xtedxX/2627_ESE_Projet_HAL_95/README.md

# 2627_ESE_Projet_HAL_95
A repository dedicated to the project of the ESE course at ENSEA
