xtedxX/2627_ESE_Projet_HAL_95/Hardware/PCB/HAL_95/PCB_contour.dxf

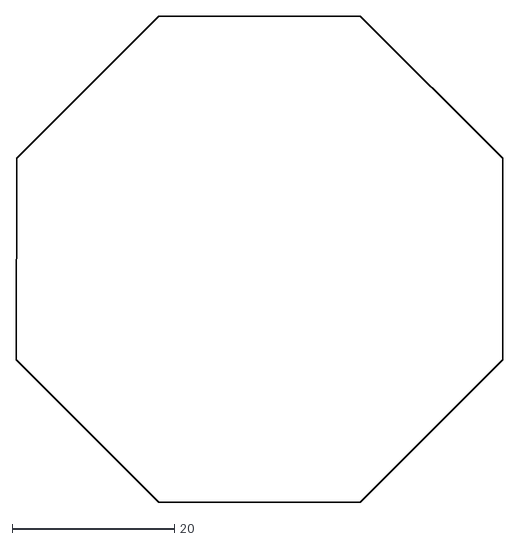
[picture p1: CAD file, 2026-09-26]
Hardware/PCB/HAL_95/PCB_contour.dxf
60.0 x 60.0
