xtedxX/2627_ESE_Projet_HAL_95/Hardware/PCB/HAL_95/PCB_contour_7x7.dxf

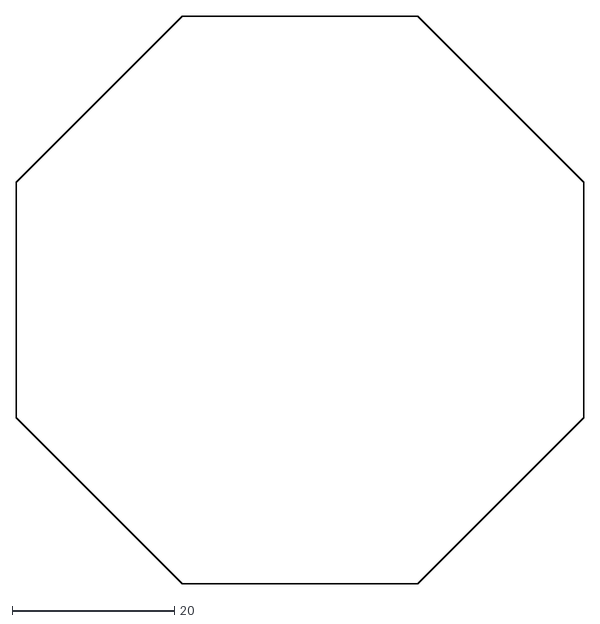
[picture p2: CAD file, 2026-09-26]
Hardware/PCB/HAL_95/PCB_contour_7x7.dxf
70.0 x 70.0
