xtedxX/2627_ESE_Projet_HAL_95/Hardware/PCB/HAL_95/PCB_contour_8x8.dxf

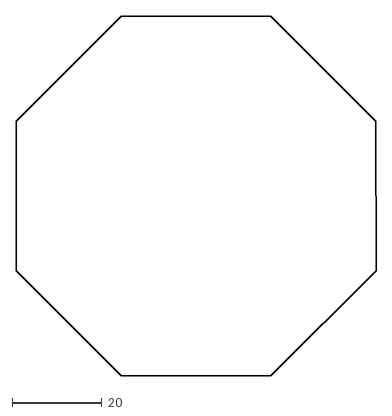
[picture p3: CAD file, 2026-09-26]
Hardware/PCB/HAL_95/PCB_contour_8x8.dxf
80.0 x 80.0
