xtedxX/2627_ESE_Projet_HAL_95/Documents/PDF_KiCad/HAL_95.pdf

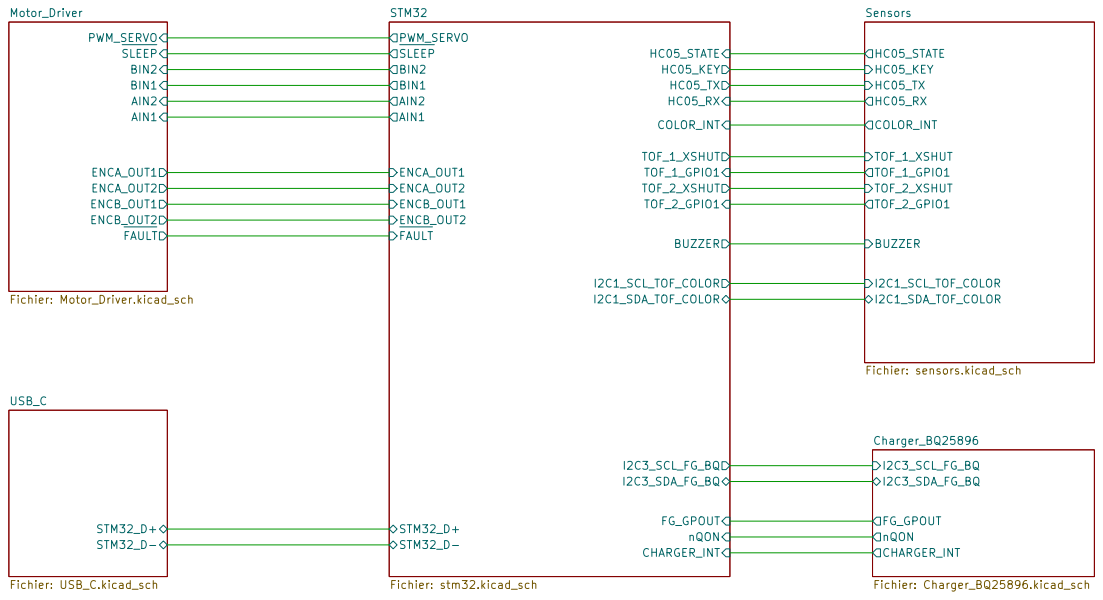
[picture p4: page 1]

Size: A4 | Rev: 1.0
KiCad E.D.A. 10.0.5 | Id: 1/6

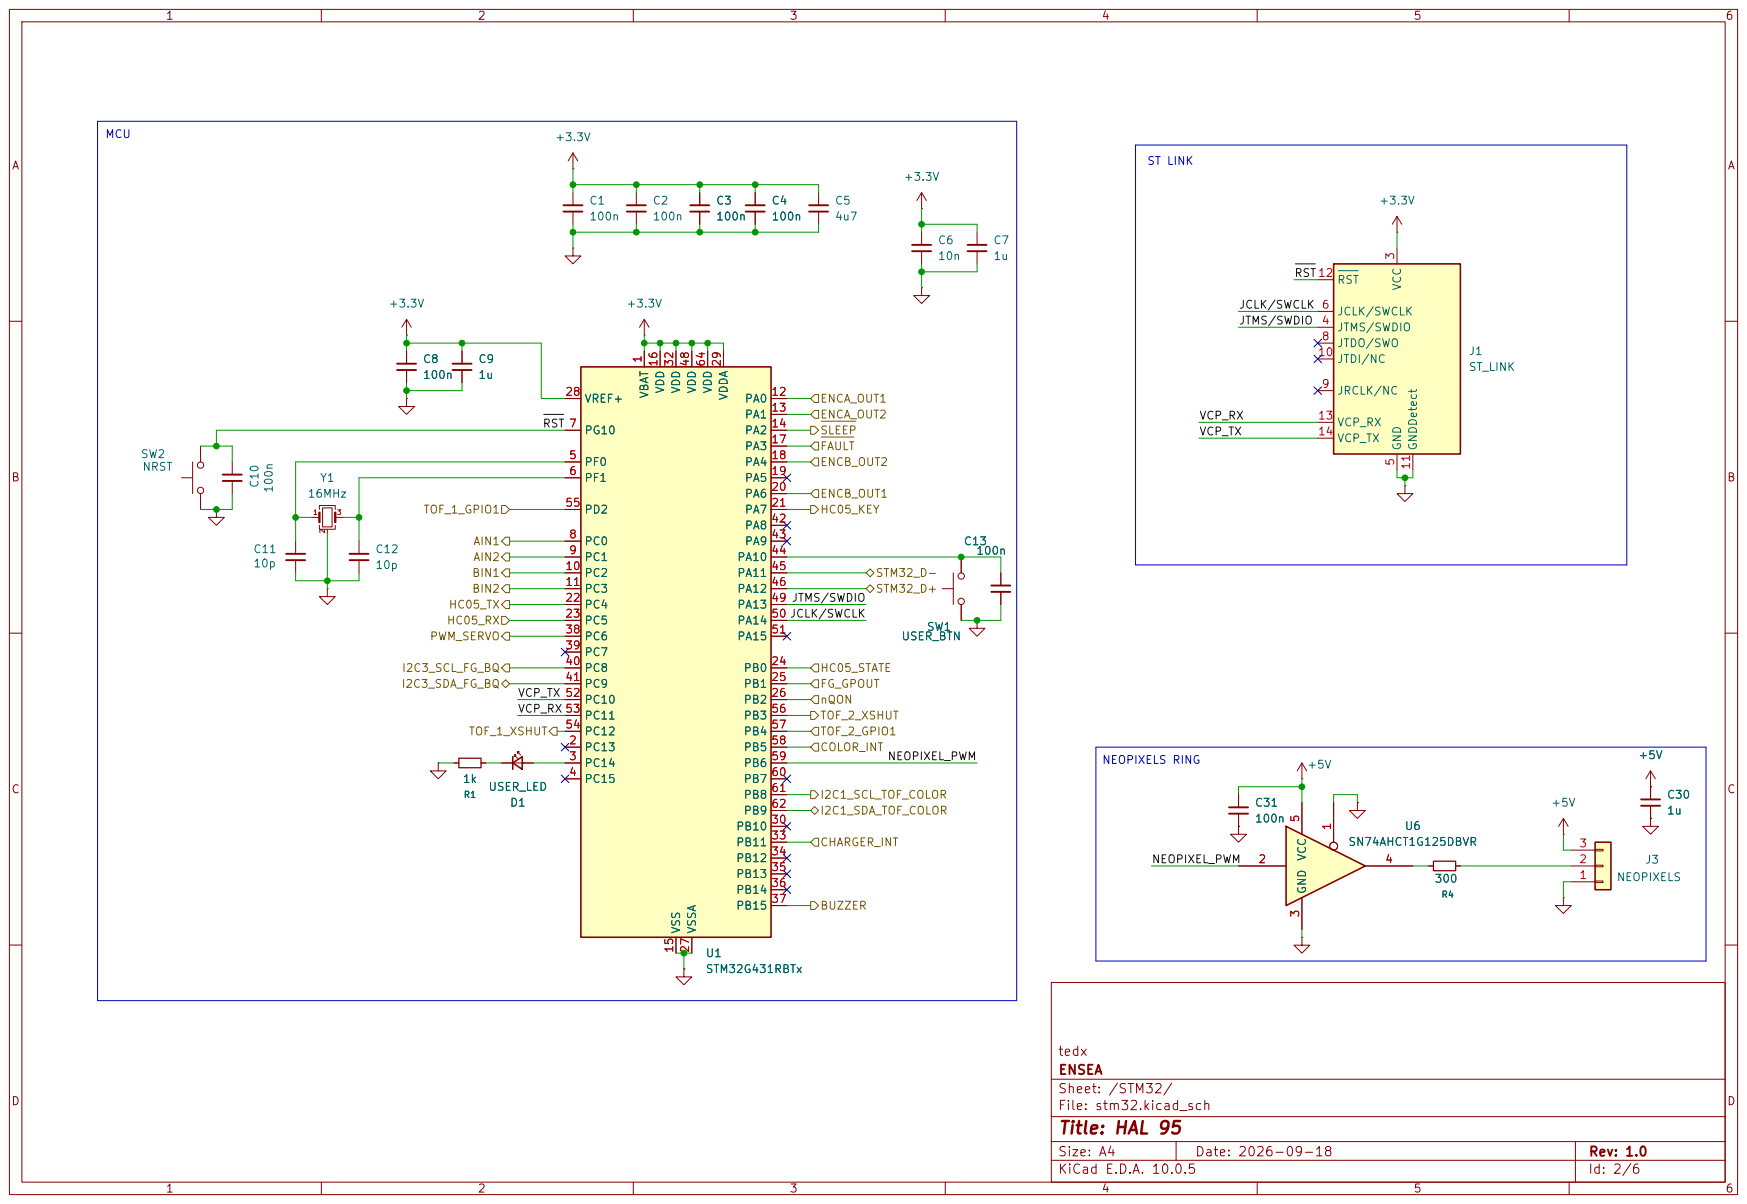
[picture p5: page 2]

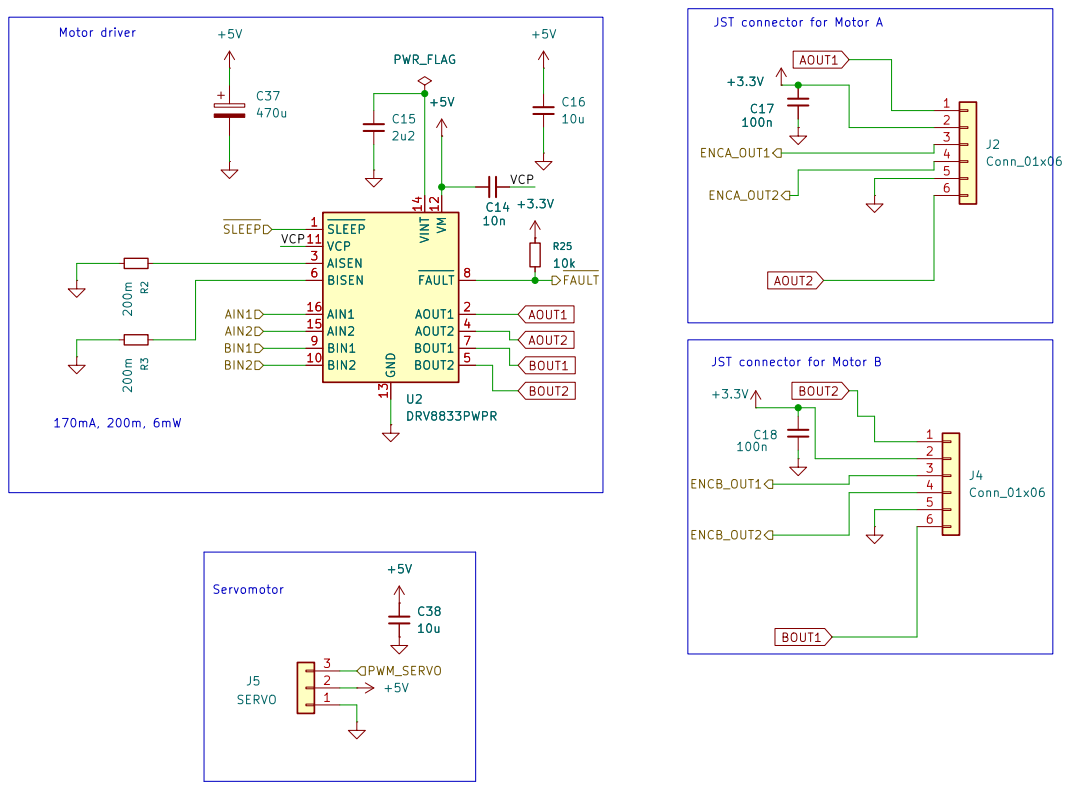
[picture p6: page 3]

JST connector for Motor A 170mA, 200m, 6mW

JST connector for Motor B

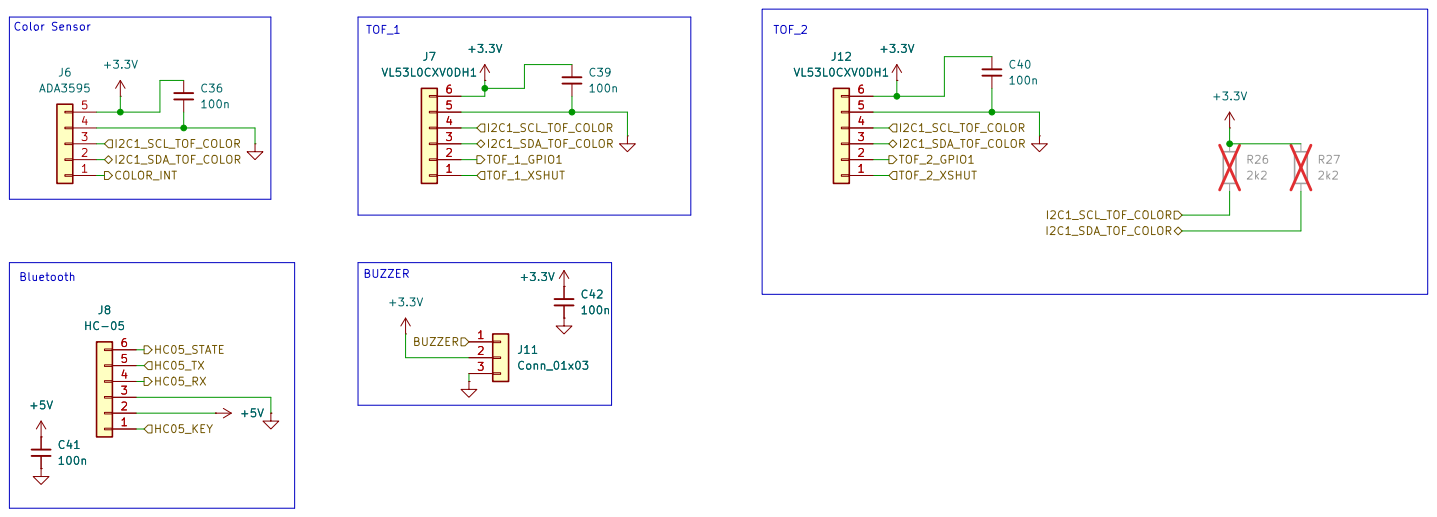
[picture p7: page 4]

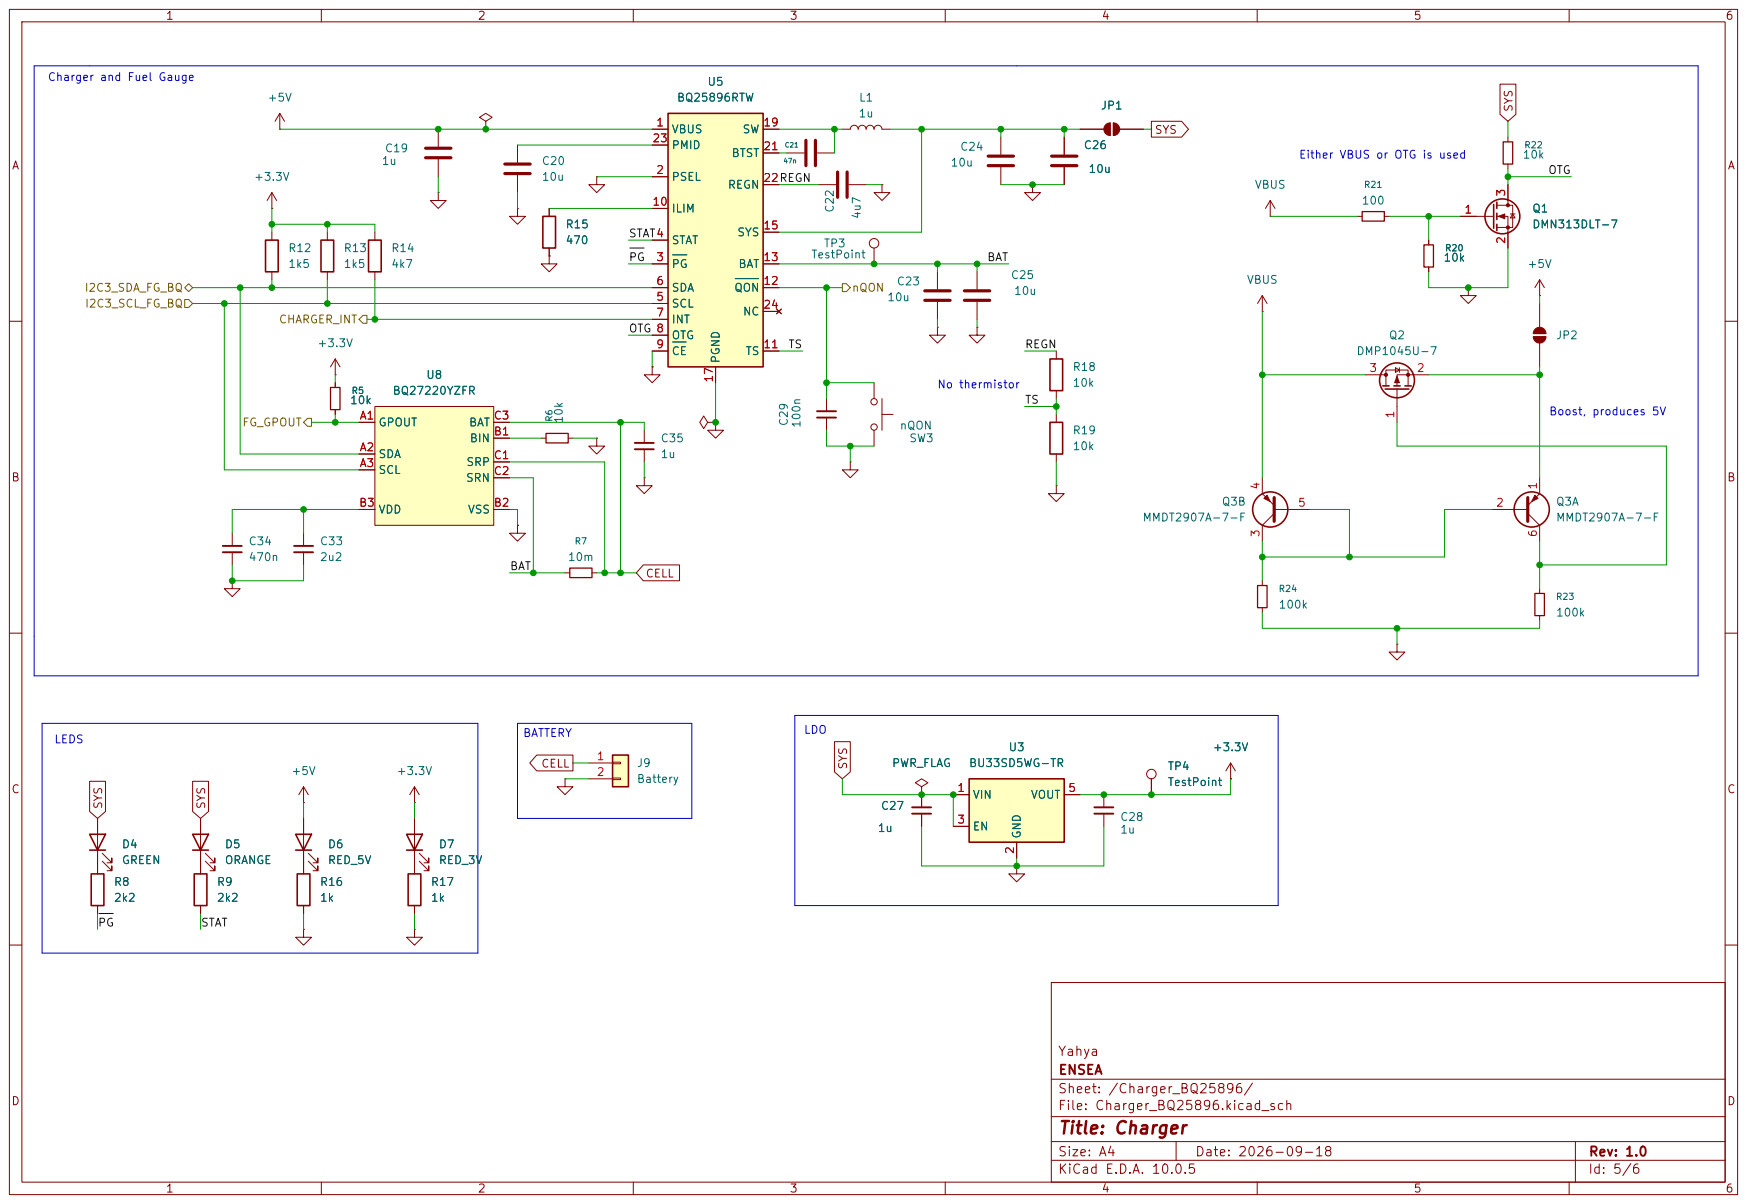
[picture p8: page 5]

Charger and Fuel Gauge

Either VBUS or OTG is used D4GREEN

Boost, produces 5V No thermistor LEDS

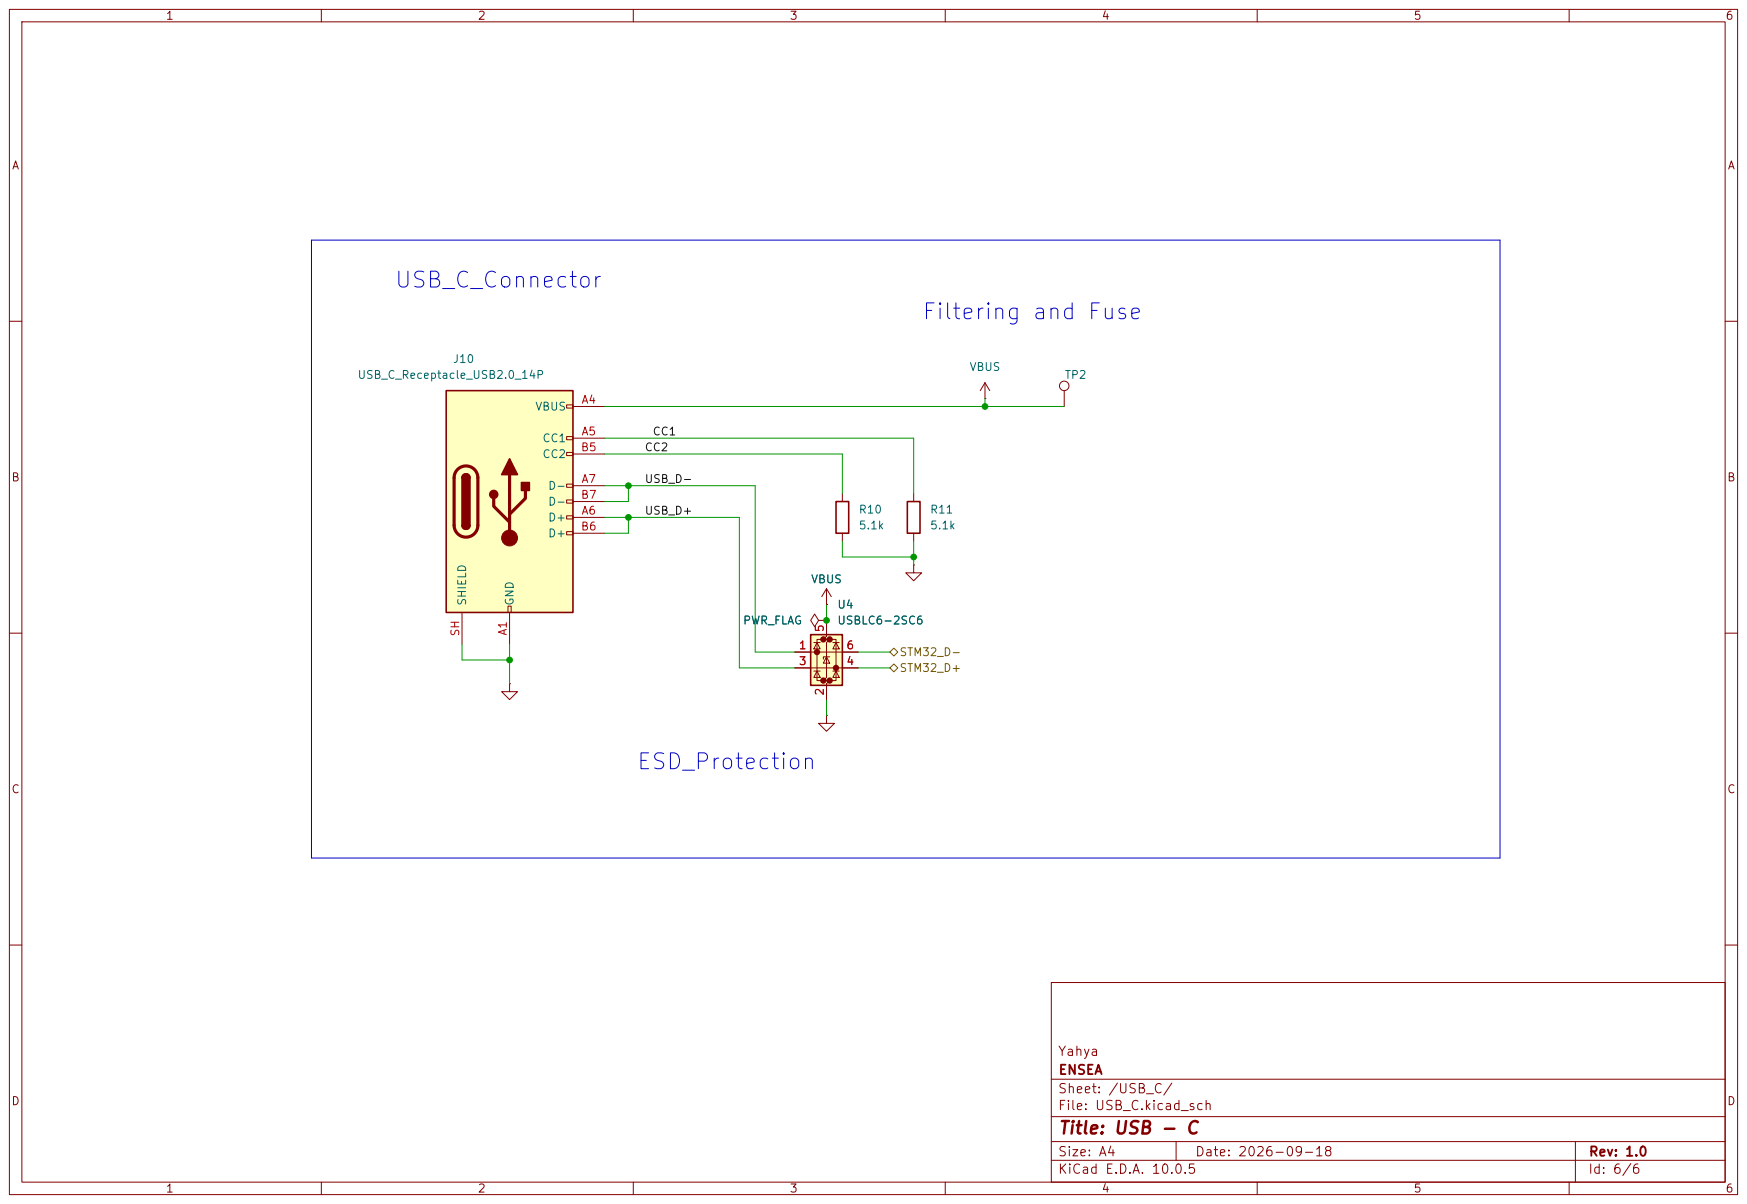
[picture p9: page 6]
