xtedxX/2627_ESE_Projet_HAL_95/Firmware/HAL_95/HAL_95.ioc

Mcu.UserName=STM32G431RBTx
PA0.GPIO_Label=ENCODER_1_A
PA0.Signal=S_TIM2_CH1
PA1.GPIO_Label=ENCODER_1_B
PA1.Signal=S_TIM2_CH2
PA10.GPIO_Label=USER_BTN
PA10.Signal=GPXTI10
PA11.Signal=USB_DM
PA12.Signal=USB_DP
PA13.Signal=SYS_JTMS-SWDIO
PA14.Signal=SYS_JTCK-SWCLK
PA2.GPIO_Label=DRV_nSLEEP
PA2.Signal=GPIO_Output
PA3.GPIO_Label=DRV_nFAULT
PA3.Signal=GPXTI3
PA4.GPIO_Label=ENCODER_2_B
PA4.Signal=S_TIM3_CH2
PA6.GPIO_Label=ENCODER_2_A
PA6.Signal=S_TIM3_CH1
PA7.GPIO_Label=HC05_KEY
PA7.Signal=GPIO_Output
PB0.GPIO_Label=HC05_STATE
PB0.Signal=GPXTI0
PB1.GPIO_Label=FG_GPOUT
PB1.Signal=GPXTI1
PB11.GPIO_Label=CHARGER_INT
PB11.Signal=GPXTI11
PB14.GPIO_Label=nQON
PB14.Signal=GPXTI14
PB15.GPIO_Label=BUZZER
PB15.Signal=S_TIM15_CH2
PB3.GPIO_Label=TOF_2_XSHUT
PB3.Signal=GPIO_Output
PB4.GPIO_Label=TOF_2_GPIO1
PB4.Signal=GPXTI4
PB5.GPIO_Label=COLOR_INT
PB5.Signal=GPXTI5
PB6.GPIO_Label=PWM_NEOPIXELS
PB6.Signal=S_TIM4_CH1
PB8-BOOT0.GPIO_Label=I2C1_SCL_TOF_COLOR
PB8-BOOT0.Signal=I2C1_SCL
PB9.GPIO_Label=I2C1_SDA_TOF_COLOR
PB9.Signal=I2C1_SDA
PC0.GPIO_Label=PWM_AIN1
PC0.Signal=S_TIM1_CH1
PC1.GPIO_Label=PWM_AIN2
PC1.Signal=S_TIM1_CH2
PC10.GPIO_Label=ST_LINK_TX
PC10.Signal=USART3_TX
PC11.GPIO_Label=ST_LINK_RX
PC11.Signal=USART3_RX
PC12.GPIO_Label=TOF_1_XSHUT
PC12.Signal=GPIO_Output
PC14-OSC32_IN.GPIO_Label=STATUS
PC14-OSC32_IN.Signal=GPIO_Output
PC2.GPIO_Label=PWM_BIN1
PC2.Signal=S_TIM1_CH3
PC3.GPIO_Label=PWM_BIN2
PC3.Signal=S_TIM1_CH4
PC4.GPIO_Label=HC05_TX
PC4.Signal=USART1_TX
PC5.GPIO_Label=HC05_RX
PC5.Signal=USART1_RX
PC6.GPIO_Label=PWM_Servo
PC6.Signal=S_TIM8_CH1
PC8.GPIO_Label=I2C3_SCL_FG_BQ
PC8.Signal=I2C3_SCL
PC9.GPIO_Label=I2C3_SDA_FG_BQ
PC9.Signal=I2C3_SDA
PD2.GPIO_Label=TOF_1_GPIO1
PD2.Signal=GPXTI2
PF0-OSC_IN.Signal=RCC_OSC_IN
PF1-OSC_OUT.Signal=RCC_OSC_OUT
