xtedxX/2627_ESE_Projet_HAL_95/(commit log)

2026-09-18 Added JP Motor Driver PCB
    [HAL95_Motor_Driver.kicad_pcb, HAL95_Motor_Driver.kicad_sch, Motor_Driver.kicad_sch]
2026-09-18 added STM32 schematic
    [HAL_95.kicad_pcb, HAL_95.kicad_sch, stm32.kicad_sch]
2026-09-19 added sensors
    [HAL_95.kicad_sch, Motor_Driver.kicad_sch, sensors.kicad_sch, stm32.kicad_sch]
2026-09-20 feat(hardware) : ajout du dossier PCB_Yahya
    [Charger_BQ25896.kicad_sch, USB_C.kicad_sch, power.kicad_pcb, power.kicad_sch]
2026-09-20 Update: modification symbole
    [Charger_BQ25896.kicad_sch, USB_C.kicad_sch]
2026-09-20 schematic done, ERC ok
    [Charger_BQ25896.kicad_sch, HAL_95.kicad_pcb, HAL_95.kicad_sch, Motor_Driver.kicad_sch, USB_C.kicad_sch, sensors.kicad_sch, stm32.kicad_sch]
2026-09-20 fixed 5V net names
    [sensors.kicad_sch, stm32.kicad_sch]
2026-09-20 Suppression du fichier autosave KiCad
2026-09-20 Ignore les fichiers autosave de KiCad
2026-09-24 finished schematic
    [Charger_BQ25896.kicad_sch, HAL_95.csv, HAL_95.kicad_sch, Motor_Driver.kicad_sch, USB_C.kicad_sch, sensors.kicad_sch, stm32.kicad_sch]
2026-09-24 reviewed schematicand ioc file
    [Charger_BQ25896.kicad_sch, Motor_Driver.kicad_sch, sensors.kicad_sch, stm32.kicad_sch]
2026-09-24 removed erc errors
    [Charger_BQ25896.kicad_sch, Motor_Driver.kicad_sch, sensors.kicad_sch, stm32.kicad_sch]
2026-09-26 changed ioc and placement
    [Charger_BQ25896.kicad_sch, HAL_95.csv, HAL_95.kicad_pcb, Motor_Driver.kicad_sch, PCB_contour.dxf, PCB_contour_7x7.dxf, PCB_contour_8x8.dxf, USB_C.kicad_sch]
2026-09-26 deleted ioc from Documents folder
    [HAL_95.csv]
2026-09-26 forgot to save kicad schematic
    [Charger_BQ25896.kicad_sch]
2026-09-30 placing components
    [Charger_BQ25896.kicad_sch, HAL_95.kicad_pcb, HAL_95.kicad_sch, USB_C.kicad_sch, stm32.kicad_sch]
2026-09-30 enhanced routing
    [Charger_BQ25896.kicad_sch, HAL_95.kicad_pcb, Motor_Driver.kicad_sch, sensors.kicad_sch, stm32.kicad_sch]
2026-09-30 updated routing
    [HAL_95.kicad_pcb, Motor_Driver.kicad_sch]
2026-09-30 chore: retrait des backups kicad de git
2026-09-30 finished routing
    [HAL_95.kicad_pcb]
2026-10-01 added logo
    [Charger_BQ25896.kicad_sch, HAL_95.csv, HAL_95.kicad_pcb, Motor_Driver.kicad_sch, sensors.kicad_sch, stm32.kicad_sch]
2026-10-01 routing done
    [HAL_95.kicad_pcb, stm32.kicad_sch]
2026-10-01 added nQON pin
2026-10-01 defined user button as exti
2026-10-05 pcb done, gerber/drill files
    [Charger_BQ25896.kicad_sch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]
2026-10-08 fixed routing
    [HAL_95-B_Cu.gbr, HAL_95-B_Mask.gbr, HAL_95-B_Paste.gbr, HAL_95-B_Silkscreen.gbr, HAL_95-Edge_Cuts.gbr, HAL_95-F_Cu.gbr, HAL_95-F_Mask.gbr, HAL_95-F_Paste.gbr]
